jvarah/ME210-final-project/final-report/final-report.html

# Team Hunger Games

In this report, we discuss the design of our robot for the ME210 Winter 2023 RobOSCARS.

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

Our report covers the mechanical design, electrical design, state diagrams, and final code.

Hero Shot

# Mechanical Designs

## Chassis

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

Chassis Exploded View

Component List:

1: Chassis Top

2: Chassis Bottom

3: Motor Ball Bearing Side Support

4: Motor Face Mount

5: Motor Support

6: Chassis Side Support

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

Chassis Side Support

## Drivetrain

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

Taped-up wheel

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

In order to drive and support the motor driven wheels, the following configuration was used:

Drivetrain Exploded View

Component List:

1: Motor

2: Shaft Coupler

3: Shaft Collar

4: Ball Bearing

5: D-Shaft

6: Wheel

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

Taped-up wheel

## Dropping Mechanism

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

Dopper Mech Paperclip

# Electrical Design

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

## Tape Sensing

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

Tape Sensing Schema

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

## IR Beacon Sensing

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

### High Level Architecture

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

IR Beacon Architecture

### Transresistive Amplifier and Prefilter (HPF)

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

IR TRamp Prefilter

### Beacon A (3333Hz) Filter

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

IR Beacon A

### Beacon B (909Hz) Filter

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

IR Beacon B

### Strength Detector (Comparator and LPF)

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

IR Strength Detector

### Completed Protoboard

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

IR Beacon Protoboard

## Motor Driver

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

Motor Driver Schema

## Arduino Pinout

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

Arduino Pinout

## Power Regulation

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

# State Diagrams

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

## Exiting Studio

For our final code, we did the following:

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

Original FSM included turning 360 degrees to read the highest IR value, then turn towards it, and then detect the black tape to determine when we had left the studio Exit studio FSM

The following image is our initial FSM for leaving the studio.

## Dispensing Press

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

The following image is our initial FSM for dispesning one press Dispensing Press FSM

## Line Follow

Our final code used a simplified approach to line follow:

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

Here is our original FSM, which employed P-only closed loop control (using difference between the left/right and center sensors as the error) Line Follow FSM

## Full FSM for Checkoff

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

Final FSM

# Code

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

All of the FSM logic is in main.cpp

## File Structure

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

## Main.cpp

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

#define PRINT_FREQ 1.0  // Hz

#include "TimerInterrupt.h"

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

#define IS_LEFT_INVERTED 1   // was 0
#define IS_RIGHT_INVERTED 0  // was 1

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

#define IS_TESTING_DRIVE 0  // Set to 1 to test the driving

#define GYRO_PORT 0x28

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

// Tape sensing
#define LEFT_WING_PORT A2
#define LINE_LEFT_PORT A3
#define LINE_RIGHT_PORT A4
#define RIGHT_WING_PORT A5

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

// Servo constants
#define HOPPER_BOT_SERVO 11
#define INDICATOR_SERVO 3
#define SERVO_MAX_ANGLE 180
#define SERVO_MIN_ANGLE 0

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

#define LINE_FOLLOW_UPDATE_FREQ 50 // ms

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

  // The following states are to get back onto the red line after leaving the
  // studio
} Line_follow_states_t;

#define ENTER_STUDIO_TIME 1100 // was 750 ESL
#define BALL_LOAD_TIME 3000
#define SKIP_RED_LINE_TIME 150

typedef enum { GOOD_PRESS, BAD_PRESS } Score_targets_t;

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

#define BACKUP_TIME 200
#define WAIT_TO_DETECT_BLACK 10000 // 5 too short, 15 seconds too long
#define BACKUP_TIME_GOOD_TO_STUDIO 400

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

#define IR_SENSE_1 A0

#define NUM_SERVOS 2
#define INDICATOR_STEPS 3
#define MOVE_INDICATOR_TIME 1000  // 5 Seconds

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

uint32_t last_time = 0;

Score_targets_t scoring_target;

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

void setup() {
  Serial.begin(9600);
  while (!Serial)
    ;

  Serial.println("Code started");

  // // Init drivebase
  drivebase = Drive(LEFT_MOTOR_DIR_PORT, LEFT_MOTOR_EN_PORT,
                    RIGHT_MOTOR_DIR_PORT, RIGHT_MOTOR_EN_PORT, GYRO_PORT);

  drivebase.setLeftInverted(IS_LEFT_INVERTED);
  drivebase.setRightInverted(IS_RIGHT_INVERTED);
  isDriving = false;

  pinMode(IR_SENSE_1, INPUT);
  Serial.println("Drivebase initialized");

  // Init more values
  hasIndicated = 0;  // Will be 2 when it's finished
  last_time = 0;
  scoring_target = GOOD_PRESS;

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

  // End to end drive test
  // if (IS_TESTING_DRIVE && !isDriving) {
  //   isDriving = true;
  //   driveTest();
  // }

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

  // if (state == EXITING_STUDIO) {
  //   switch (line_follow_state) {
  //     case LINE_FOLLOW_UNTIL_BLACK_TAPE:
  //       followLine();
  //       break;
  //   }
  // }

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

## Drive

### Drive.h

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

#ifndef Drive_h
#define Drive_h
#include <Adafruit_I2CDevice.h>
#include <Adafruit_BNO055.h>
#include <inttypes.h>

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

#endif

### Drive.cpp

/**
 * Drive.cpp is the implementation for the drive subsystem
 */
#include "Drive.h"

#define USE_EXT_CRYSTAL true

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

#define LEFT_SCALAR 1.0 // was 0.95 ESL
#define RIGHT_SCALAR 0.97 // was 0.1 ESL

#define GYRO_DEGREES 360.0  // Max value from gyro (0 - 359.9999)
#define GYRO_HALF_DEGREES (GYRO_DEGREES / 2)

Drive::Drive() {
  // Ports default to garbage values
  inverts_and_states = 0;
}

Drive::Drive(uint8_t left_dir_port, uint8_t left_en_port,
             uint8_t right_dir_port, uint8_t right_en_port, uint8_t gyro_prt) {
  // State initialization
  inverts_and_states = 0;

  // Gyro initialization
  gyro_offset = 0;
  gyro_port = gyro_prt;

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

  // Motor initialization
  l_dir_port = left_dir_port;
  l_en_port = left_en_port;
  r_dir_port = right_dir_port;
  r_en_port = right_en_port;

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

  setLeftDir(FORWARD);
  setRightDir(FORWARD);
  stopMotors();
}

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

bool Drive::isLeftInverted() { return inverts_and_states & LEFT_INVERT_MASK; }

bool Drive::isRightInverted() { return inverts_and_states & RIGHT_INVERT_MASK; }

bool Drive::leftDir() { return inverts_and_states & LEFT_DIR_MASK; }

bool Drive::rightDir() { return inverts_and_states & RIGHT_DIR_MASK; }

void Drive::setGyroInit() { inverts_and_states |= GYRO_INIT_MASK; }

bool Drive::getGyroInit() { return inverts_and_states & GYRO_INIT_MASK; }

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

void Drive::stopMotors() {
  setRightPower(0);
  setLeftPower(0);
}

double Drive::getAngle() {
  if (getGyroInit()) {
    double yaw =
        gyro.getVector(Adafruit_BNO055::VECTOR_EULER).x() - gyro_offset;

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

  double error = target_angle - getAngle();
  if (error > GYRO_HALF_DEGREES) {
    error -= GYRO_DEGREES;
  }
  return error;
}

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

void Drive::printDebug() {
  Serial.print("Gyro angle: ");
  Serial.println(getAngle());
}

## Hopper

### Hopper.h

/**
 * Wrapper for the hopper subsystem, allows user to drop x number of balls
*/

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

#endif

### Hopper.cpp

/**
 * Hopper subsystem wrapper
 */

#include <Arduino.h>
#include <Hopper.h>

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

Hopper::Hopper() { _is_attached = false; }

Hopper::Hopper(Servo &servo, uint8_t servo_port) {
  _servo = servo;
  _servo.attach(servo_port);
  _servo.write(DEFAULT_ANGLE);
  _is_attached = true;
}

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

bool Hopper::isInitialized() {
    return _is_attached;
}

## Line Follow

### LineFollow.h

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

#ifndef LineFollow_h
#define LineFollow_h
#include <inttypes.h>
#include <LineDataTypes.h>

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

};
#endif

### LineFollow.cpp

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

#include "LineFollow.h"

#include <Arduino.h>

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

void LineFollow::setThresholds(Line_thresholds_t thresholds) {
  _thresholds = thresholds;
}

Line_sensor_vals_t LineFollow::getSensorReadings() {
  return {analogRead(_left_wing), analogRead(_right_wing),
          analogRead(_line_left), analogRead(_line_right)};
}

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

  return rw_black;
}

bool LineFollow::testForLeftWingBlack() { // ESL
  return isBlack(analogRead(_left_wing), _thresholds.max_lw_red);
}

bool LineFollow::testForRightWingBlack() { // ESL
  return isBlack(analogRead(_right_wing), _thresholds.max_rw_red);
}

bool LineFollow::testForLeftWingRed() {
  return isRed(analogRead(_left_wing), _thresholds.min_lw_white,
               _thresholds.max_lw_red, _thresholds.max_lw_black);
}

bool LineFollow::testForRightWingRed() {
  return isRed(analogRead(_right_wing), _thresholds.min_rw_white,
               _thresholds.max_rw_red, _thresholds.max_rw_black);
}

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

Motor_powers_t LineFollow::getLineFollowPowers(double k_p, int8_t base_power) {
  uint16_t left_value = analogRead(_line_left);
  uint16_t right_value = analogRead(_line_right) + 1;

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

bool LineFollow::isBlack(uint16_t sensor_value, uint16_t max_red) {
  return sensor_value > (max_red + RED_BLACK_WIGGLE_ROOM);
}

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

### LineDataTypes.h

#ifndef LineDataTypes_h
#define LineDataTypes_h
#include <inttypes.h>

typedef struct {
  int8_t left_power;
  int8_t right_power;
} Motor_powers_t;

typedef struct {
  uint16_t min_lw_white;
  uint16_t max_lw_red;
  uint16_t max_lw_black;

  uint16_t min_ll_white;
  uint16_t max_ll_red;
  uint16_t max_ll_black;

  uint16_t min_lr_white;
  uint16_t max_lr_red;
  uint16_t max_lr_black;

  uint16_t min_rw_white;
  uint16_t max_rw_red;
  uint16_t max_rw_black;
} Line_thresholds_t;

typedef struct {
  uint16_t lw;
  uint16_t ll;
  uint16_t lr;
  uint16_t rw;
} Line_sensor_vals_t;

#endif

# Bill of Materials

BOM
