jvarah/ME210-final-project/(commit log)

2023-03-01 Update inversions, pass gyro to Drive via main.cpp()
2023-03-02 Move gyro into drivebase, fix gyro offset
    [main.cpp]
2023-03-02 Scale turning error to [-180, 180)
    [main.cpp]
2023-03-03 Remove Extra IR Sensor and Its Checks
2023-03-04 Use 3 line sensors instead of 4
2023-03-04 Comment out gyro (wasn't working), fix .gitignore
    [main.cpp]
2023-03-08 Add different thresholds for each sensor
2023-03-09 Add PID Line follow
2023-03-09 Sometimes doesn't turn 180, detects line too early
    [main.cpp]
2023-03-11 Inconsistent due to wheel slip, only goes to good press
    [main.cpp]
2023-03-30 Add final report (#7)
    * Add final report file with finite state machines
    * Add code to final report
    * Added "Drivetrain" section to final report
    * Added "Drivetrain" section to final report
    * Added "BOM" section
    * Updated "BOM" section in final report
    * Added "Chassis" section to final report
    * Updated "Chassis" section in final report
    * Added Electrical Design section to final report
    * Updated "Drivetrain" section in final report
    * Added dropping mechanism bit
    * new file: final-report/dropMounted.png
    new file: final-report/dropper.png
    new file: final-report/paperclip.png
    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
